cy384/ppk_usb/(list of files, cad)

Other CAD files:
palm-V-adapter.scad
