cy384/ppk_usb/(threads)

Thread 1 (2015-04-12):

Possible Updates?

danielfrausto, 2015-04-12:
hi i have been following your work. Might it be possible for you to help port this code to leonardo?
Also i am using landware gotype keyboard for pam III? can you help?

cy384, 2015-04-12:
I'm fairly confident the code should run on a Leonardo with no changes (or just changing some of the pin numbers, maybe).

As for the landware keyboard, unfortunately, I can't find any technical information about it online (and I don't have one), so it would be harder to figure out.  You would probably need a logical analyzer or something to capture and reverse engineer the communications.

DB35M, 2015-04-13:
Hi i  am also using leonardo. i am having problems with pin 15 from your micro pro... there is no pin 15 on leonardo. I have read Micro pro schematic and pin 15 i s SCK but on leonardo that pin goes to ICP.

cy384, 2015-04-15:
You should be able to change that (the PULLDOWN_PIN macro) to basically any other pin you want to wire up, or just ignore it and pull down using GND.

Closed 2015-05-03.

Thread 2 (2015-10-29):

Any way to debug?

hryamzik, 2015-10-29:
Hi @cy384!

I've connected everything exactly as you've described and it doesn't work. Should the board always appear in the system as "Leonardo" or should there be a different name in a keyboard mode?

cy384, 2015-10-29:
Hi, just added a debug option, try it out by grabbing the latest code and recompiling with DEBUG set to 1.  It should at least give you an idea of where in the process it's failing to work (it will print to the arduino serial monitor).  The board will continue to show up as a leonardo in lsusb or similar lists.

Beyond looking at that, checking your wiring again, make sure you defined PPK_VERSION correctly for your keyboard, maybe poke at it with a multimeter/logic analyzer if you have one, dig into the code and the specification for the keyboard, and hope you don't have any dead hardware.

If you have an extra atmega32u4 based arduino, you could try wiring it up on a solderless breadboard and use test hooks to connect it to the keyboard until you can get it working (which is how I initially did mine before the 3d printed parts).

hryamzik, 2015-10-29:
Got it, thanks!

hryamzik, 2015-10-29:
@cy384 the bad news is that I can see nothing in the serial console. The good news is that it actually started working, should have been a contact issue on a bread board.

Let me ask two more questions:

1. What's the reason for wiring pins 6 and 8 (in a palm V version)?
2. Can I just replace pin 15 with pin 9 (I would like to use an SMD resistor)

cy384, 2015-10-29:
Regarding the issues with the serial console, often I have to make sure manually that it's choosing the right usb/serial port every time I connect the device.

1.  The two reasons for the strange wiring: firstly, simply getting everything to physically fit nicely, and secondly, for reasons unknown to me I could only get the keyboard serial connection to work on certain pins (which I found by just testing them one by one).  I suspect the latter has something to do with interrupts used by the software serial library, but didn't investigate further once I found a way to make it work.

2.  You could replace 15 with any unused I/O pin if you adjust PULLDOWN_PIN, or even just use ground.  It's only used to pull down the serial pin.  15 was just located conveniently for a normal 1/4W through-hole resistor.

Closed 2015-10-29.

Thread 4 (2016-01-05):

Error uploading

alchle, 2016-01-05:
cy384,

Found this great post on github and am trying it out.  I 3D printed the parts (fits nicely) and am ready to upload the code.  I want to test it on an Arduino Uno first before purchasing a Leonardo and maybe that is my problem. I was hoping that I could connect the Arduino Uno to my tablet and see how well it works, it has a USB port and built in serial communication like the Leonardo.

When I upload the code (changed to Palm V) I get the following errors... looks like it doesn't like the config keymap functions.  Board in Arduino IDE is Arduino Uno, and programmer is USBtinyISP (I never change this setting)

Palm_Keyboard.ino: In function 'void config_keymap()':
Palm_Keyboard:87: error: 'KEY_LEFT_GUI' was not declared in this scope
Palm_Keyboard:107: error: 'KEY_CAPS_LOCK' was not declared in this scope
Palm_Keyboard:108: error: 'KEY_TAB' was not declared in this scope
Palm_Keyboard:109: error: 'KEY_LEFT_CTRL' was not declared in this scope
Palm_Keyboard:120: error: 'KEY_LEFT_ALT' was not declared in this scope
Palm_Keyboard:139: error: 'KEY_BACKSPACE' was not declared in this scope
etc...
for all key_map in both functions:  'void config_keymap()' & void config_fnkeymap()'

Please help.

Thanks

cy384, 2016-01-05:
The Arduino Uno isn't able to easily act as a USB keyboard, so it doesn't have the KEY_LEFT_GUI etc. available for this code.  If you want to just see if you can get the serial stuff working, you could try experimenting with this quickly edited version of the code, which will just print the keypresses to the serial console: https://gist.github.com/cy384/dd638ba8a37c22766444

If you want to use this as a USB keyboard, though, you'll need to get a Leonardo, Pro Micro, or other Arduino with an Atmega32U4.

alchle, 2016-01-06:
Worked great.  Thank you.  I ordered a Leonardo.

Great work!

-Allen

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

techsetonyoutube, 2017-03-31:
get a Digispark board there small and cheap!

http://www.ebay.com/itm/like/191544650607?lpid=82&chn=ps&ul_noapp=true

Closed 2016-01-05.

Thread 5 (2016-02-04):

Sometimes works on computer, Not on tablets

alchle, 2016-02-04:
Dear cy384,

I was successful in making the adapter.  I have gotten the palm keyboard to work on my WinXP and Win7 machines, however, it's not always successful... Very first time plugged into my WinXP machine USB port it worked perfectly, but when I unplugged it and plugged in back i, it doesn't work.  Computer makes the sounds of added USB item and says ready to use but the keyboard doesn't work.  Unplug, plug and repeat... no go.  Finally, I plugged it in and grounded the Reset pin with a paper clip and released, now it works (until I unplug and replug again). (Any time is is plugged in the micro controller has the led light on).  I know when it working because the red led with flash with each keypress.

Next issue is I can't get it to work with my tablets.  A normal keyboard will work just fine (no powered USB hub needed) but for some reason the tablets won't see the Leonardo device.  Driver perhaps?  Tried on 3 different tablet models/manufacturers.  Any thoughts here?  This is why I made it in the first place.

Awesome work on your part.  Thank you for posting it and help.

-Allen

cy384, 2016-02-06:
For determining what problems you're having on your PC, I would advise compiling the firmware in debug mode (set PPK_DEBUG to 1 in the .ino file) and looking at what is printed in the serial console.  That should let you see where it's getting stuck, and possibly what to do about it.  I think you could also look at Windows Device Manager and make sure it shows up as a USB keyboard/HID.

I'm not sure why it would work on your PC and not on tablets; it has worked on all computers and (android) mobile devices I've tested on.  I don't think any additional drivers should be necessary.  It may be related to the intermittent problems you've been having with the PCs.  Unfortunately, I don't know what tools would be useful for figuring out what's happening on phones/tablets.

Hope this helps.

Thread 6 (2016-05-30):

Pin 15 non-existent on arduino Leonardo

DavidVentura, 2016-05-30:
Hi
I have an original arduino leonardo which I'll try to use to test this with my v3 PPK.. thing is I have up to Pin 13. Following this:

MISO, MOSI and SCK:
First there is an SPI header on the Leonardo board. The pins connected to the SPI header are MISO (PB3), MOSI (PB2) and SCK (PB1). If you want to use them as I/O pins here is a secret. You can use them same as any other digital pin on Leonardo. Use the corresponding digital pin number:
MISO as digital pin 14
MOSI as digital pin 16
SCK as digital pin 15

I get that  I should use the SCK pin (upper middle) on the  SPI header
 Thanks

DavidVentura, 2016-05-30:
Well, I couldn't wait. Yes, the SCK pin works. I am typing from my new PPK!

cy384, 2016-05-30:
Great to hear you've got it working, enjoy!

For the record, the exact pins used aren't critical, you could probably tweak the code to use most other pins instead.

Closed 2016-05-30.

Thread 7 (2016-05-31):

Making it work on ATMega328

DavidVentura, 2016-05-31:
Do you believe this should work on a 328? I can get them for 6USD where I am and the 32u4 costs 24USD.
It seems able to work as a HID device and has software serial compatibility

cy384, 2016-06-01:
The smaller arduinos/atmega devices can do hacky low-speed USB, but you'd still need a few more parts (zener diodes, etc.), and the code for this project would need to be adapted.  So, probably possible in a technological sense, but it would take more work and experimentation.

Closed 2016-06-01.

Thread 8 (2017-04-17):

can I use the original palm connector

rhubarb, 2017-04-17:
Hi I'm very interested in reviving my PPK from the brick-like hibernation it's been in since I upgraded from a Palm V to a Tungsten oh many moons ago. But I don't have access to a 3D printer.
I _do_ still have my Palm V that the keyboard worked with. Can I pull out it's connector and use it instead?

cy384, 2017-04-20:
Last time I looked (I may be wrong), the connector piece of a Palm V was not a nice independent module that you could pull out, and was pretty integrated into the rest of the hardware.  If you're not worried about making a nicely removable adapter, you could do something like soldering directly to the connector pins on the keyboard.

Closed 2017-07-12.

Thread 9 (2017-07-12):

Unable to upload to Pro Micro

trizex, 2017-07-12:
Hello, I hope you can shed some light on the issue that i'm having. I bought a knockoff from aliexpress

https://www.aliexpress.com/item/New-Pro-Micro-ATmega32U4-5V-16MHz-Replace-ATmega328-for-Ar-Pro-Mini/1859136734.html

It identifies itself in IDE as Arduino Leonardo, but once i try to upload the file, it comes back with a
"KEY_LEFT_GUI" not declared in this scope. Basically the same issue you already had reported by somebody else, so I tried your debugging file (nokeyboard), and....that works. Do you have any ideas as to why I'm experiencing this issue, is the knockoff to blame or? The board looks damn near identical to the one you used. Thank you in advance, hope you can help me out.

trizex, 2017-07-12:
Rhis is the complete error log

Arduino: 1.8.3 (Windows 7), Board: "Arduino Leonardo"

.....ppk_usb-master\ppk_usb-master\arduino_ppk_usb\arduino_ppk_usb.ino: In function 'void config_keymap()':

arduino_ppk_usb:88: error: 'KEY_LEFT_GUI' was not declared in this scope

   key_map[0b00001000] = KEY_LEFT_GUI; // "CMMD" or "Cmd"

                         ^

arduino_ppk_usb:108: error: 'KEY_CAPS_LOCK' was not declared in this scope

   key_map[0b00011000] = KEY_CAPS_LOCK;

                         ^

arduino_ppk_usb:109: error: 'KEY_TAB' was not declared in this scope

   key_map[0b00011001] = KEY_TAB;

                         ^

arduino_ppk_usb:110: error: 'KEY_LEFT_CTRL' was not declared in this scope

   key_map[0b00011010] = KEY_LEFT_CTRL;

                         ^

arduino_ppk_usb:121: error: 'KEY_LEFT_ALT' was not declared in this scope

   key_map[0b00100011] = KEY_LEFT_ALT;

                         ^

arduino_ppk_usb:140: error: 'KEY_BACKSPACE' was not declared in this scope

   key_map[0b00110010] = KEY_BACKSPACE;

                         ^

arduino_ppk_usb:159: error: 'KEY_RETURN' was not declared in this scope

   key_map[0b01000001] = KEY_RETURN;

                         ^

arduino_ppk_usb:169: error: 'KEY_UP_ARROW' was not declared in this scope

   key_map[0b01001001] = KEY_UP_ARROW;

                         ^

arduino_ppk_usb:178: error: 'KEY_DELETE' was not declared in this scope

   key_map[0b01010000] = KEY_DELETE;

                         ^

arduino_ppk_usb:179: error: 'KEY_LEFT_ARROW' was not declared in this scope

   key_map[0b01010001] = KEY_LEFT_ARROW;

                         ^

arduino_ppk_usb:180: error: 'KEY_DOWN_ARROW' was not declared in this scope

   key_map[0b01010010] = KEY_DOWN_ARROW;

                         ^

arduino_ppk_usb:181: error: 'KEY_RIGHT_ARROW' was not declared in this scope

   key_map[0b01010011] = KEY_RIGHT_ARROW;

                         ^

arduino_ppk_usb:188: error: 'KEY_LEFT_SHIFT' was not declared in this scope

   key_map[0b01011000] = KEY_LEFT_SHIFT;

                         ^

arduino_ppk_usb:189: error: 'KEY_RIGHT_SHIFT' was not declared in this scope

   key_map[0b01011001] = KEY_RIGHT_SHIFT;

                         ^

......\ppk_usb-master\ppk_usb-master\arduino_ppk_usb\arduino_ppk_usb.ino: In function 'void config_fnkeymap()':

arduino_ppk_usb:200: error: 'KEY_HOME' was not declared in this scope

   fn_key_map[0b01010001] = KEY_HOME; // left arrow

                            ^

arduino_ppk_usb:201: error: 'KEY_PAGE_DOWN' was not declared in this scope

   fn_key_map[0b01010010] = KEY_PAGE_DOWN; // down arrow

                            ^

arduino_ppk_usb:202: error: 'KEY_END' was not declared in this scope

   fn_key_map[0b01010011] = KEY_END; // right arrow

                            ^

arduino_ppk_usb:203: error: 'KEY_PAGE_UP' was not declared in this scope

   fn_key_map[0b01001001] = KEY_PAGE_UP; // up arrow

                            ^

arduino_ppk_usb:204: error: 'KEY_ESC' was not declared in this scope

   fn_key_map[0b00011001] = KEY_ESC; // tab key

                            ^

arduino_ppk_usb:205: error: 'KEY_F1' was not declared in this scope

   fn_key_map[0b00000000] = KEY_F1; // 1

                            ^

arduino_ppk_usb:206: error: 'KEY_F2' was not declared in this scope

   fn_key_map[0b00000001] = KEY_F2; // 2

                            ^

arduino_ppk_usb:207: error: 'KEY_F3' was not declared in this scope

   fn_key_map[0b00000010] = KEY_F3; // 3

                            ^

arduino_ppk_usb:208: error: 'KEY_F4' was not declared in this scope

   fn_key_map[0b00000100] = KEY_F4; // 4

                            ^

arduino_ppk_usb:209: error: 'KEY_F5' was not declared in this scope

   fn_key_map[0b00000101] = KEY_F5; // 5

                            ^

arduino_ppk_usb:210: error: 'KEY_F6' was not declared in this scope

   fn_key_map[0b00000110] = KEY_F6; // 6

                            ^

arduino_ppk_usb:211: error: 'KEY_F7' was not declared in this scope

   fn_key_map[0b00000111] = KEY_F7; // 7

                            ^

arduino_ppk_usb:212: error: 'KEY_F8' was not declared in this scope

   fn_key_map[0b00110100] = KEY_F8; // 8

                            ^

arduino_ppk_usb:213: error: 'KEY_F9' was not declared in this scope

   fn_key_map[0b00110101] = KEY_F9; // 9

                            ^

arduino_ppk_usb:214: error: 'KEY_F10' was not declared in this scope

   fn_key_map[0b00110110] = KEY_F10; // 0

                            ^

arduino_ppk_usb:215: error: 'KEY_F11' was not declared in this scope

   fn_key_map[0b00110000] = KEY_F11; // -

                            ^

arduino_ppk_usb:216: error: 'KEY_F12' was not declared in this scope

   fn_key_map[0b00110001] = KEY_F12; // =

                            ^

.....\ppk_usb-master\ppk_usb-master\arduino_ppk_usb\arduino_ppk_usb.ino: In function 'void setup()':

arduino_ppk_usb:348: error: 'Keyboard' not found. Does your sketch include the line '#include <Keyboard.h>'?
   Keyboard.begin();

   ^

......\ppk_usb-master\ppk_usb-master\arduino_ppk_usb\arduino_ppk_usb.ino: In function 'void loop()':

arduino_ppk_usb:379: error: 'Keyboard' not found. Does your sketch include the line '#include <Keyboard.h>'?
         Keyboard.releaseAll();

         ^

arduino_ppk_usb:389: error: 'Keyboard' not found. Does your sketch include the line '#include <Keyboard.h>'?
             Keyboard.release(key_code);

             ^

arduino_ppk_usb:393: error: 'Keyboard' not found. Does your sketch include the line '#include <Keyboard.h>'?
             Keyboard.press(key_code);

             ^

exit status 1
'KEY_LEFT_GUI' was not declared in this scope

trizex, 2017-07-12:
So for future reference, I managed to get it working. It was missing a line ,the IDE told me but I wasn't listening :D

"#include <Keyboard.h>"

And voilla, it wooooorks :D

cy384, 2017-07-12:
glad you got it working!

Closed 2017-07-12.

Thread 10 (2017-10-13):

using a usb to serial converter?

bijlevel, 2017-10-13:
This is a shot in the dark, but just using a usb to serial converter, like http://www.sigma-shop.com/product/79/modulo-usb-seriale-ft232rl-usb-b-ub232r-atmel-avr-microchip-pic-arduino.html, would that work? Or is it indeed necessary to use a programmable board to get the right key codes? TIA!

cy384, 2017-10-13:
It's probably possible to get data from the keyboard using an RS232 adapter, but you'd also have to do something to turn that into keyboard input on the computer, and it wouldn't be any cheaper or simpler, so I think the arduino-based solution as done in this project is the most reasonable option.

bijlevel, 2017-10-14:
Thanks for the reply! I will try to implement your solution.

Regards,
Sjoerd W. Bijleveld

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

Closed 2017-10-13.

Thread 11 (2018-03-14):

Not sure how to use SCAD files

fionnafire, 2018-03-14:
I know this is pretty old, but can you please provide a more universal file such as an STL please?

fionnafire, 2018-03-14:
oof. I have hardly used Github

cy384, 2018-03-15:
thanks for your interest, the files can be opened with [OpenSCAD](http://www.openscad.org/), and it's pretty easy to generate an STL.  As I'm traveling right now, it might be a few days, but I'll upload some as soon as I can.

fionnafire, 2018-03-15:
thank you very much! I can't wait to get this thing working on my phone.

cy384, 2018-05-02:
Sorry for the delayed response, coursework has kept me very busy for the past two months (finals ended yesterday).  [I've added a 1.0.0 release and attached the compiled STLs.](https://github.com/cy384/ppk_usb/releases/tag/v1.0.0)

If you need to tweak the files, you can also try pasting the code into [this in-broswer openscad.](http://openscad.net/)

fionnafire, 2018-05-03:
Thank you so much. You of course had no obligation to make the STL files for me, I really appreciate your work!

I hope your finals went well, and honestly my own college and work schedule would have kept me from being able to make this thing myself anyway. So no worries about the delay.

Closed 2018-03-15.

Thread 12 (2018-05-29):

Is it real to connect palm keyboard to PC rs232 (on ms dos)?

be3max, 2018-05-29:
Is it real to connect palm keyboard to PC rs232 (on ms dos)? I`m own old [HP 200lx](https://en.wikipedia.org/wiki/HP_200LX) that's have a rs232 port, these handledPC work on ms dos, and i searching info about keyboard connection on rs232.
HP 200lx can connect with [Apple Newton keyboard](http://www.palmtoppaper.com/ptphtml/36/pt360021.htm) + driver, but which hard to find nowadays :(

cy384, 2018-06-24:
That looks like a cool device!

Can it conceivably be done? I suspect yes.  Do I have any idea how to do it? Nope!  It would probably also need a special driver, in addition to figuring out the wiring.

Sorry I can't help, I hope you figure something out and can keep the old hardware alive.

Closed 2018-06-24.

Thread 13 (2019-04-26):

Bluetooth connectivity

hmngsghst, 2019-04-26:
Hello! Thanks for sharing this cool mod! Have started to fiddle with electronics, found a PPK at the flea market, googled for an adapter and was happy to find your mod. Am thinking about doing it and was wondering about the possibility of BT connectivity with new BLE-equipped 32u4 boards like the Adafruit Feather 32u4 Bluefruit LE. It seems possible, but without any experience with Arduinos and not much knowledge in electronics and programming, would it be too much of a hassle/hard and too much for a beginner to get this working via bluetooth? Would it need for example power on/off buttons and such? Will be doing it anyway with or without the bluetooth and am ready to put some work into it as a learning experience.

cy384, 2019-04-27:
I'm sure it's possible, though I can't say how hard it would be for a beginner.  I think a person could get it working pretty easily based on the tutorials for the feather/bluefruit boards.  The 3D printed parts won't be sized correctly for the board with a battery, and exact pin numbers used will be different, but those should be relatively straight-forward to figure out.  You could probably just have a slide switch on the battery connection for the power.

hmngsghst, 2019-04-30:
Reading up on the stuff it doesn't seem too hard... Still looking at different possibilities. Might get a bit bulky with the battery, and the cost too..Thanks for the help!

Thread 14 (2019-05-19):

keyboard.h

CableGuy67, 2019-05-19:
I finally sat down to finish this project and it went about as smooth as could be. So thanks for all your work!

The only issue I had with Arduino 1.8.5 and building for a Pro Micro (ish, from ebay) I had to add:
`#include <Keyboard.h>`
just after the SoftwareSerial include to get it to compile. After that, I was able to upload  the sketch and type this out on my old Palm keyboard.
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

cy384, 2019-05-19:
it's very encouraging to see a successful build, thanks for sharing!  I've added the header in the last commit.

Closed 2019-05-19.

Thread 15 (2020-08-31):

for Handspring

aoshimak, 2020-08-31:
I tried for Palm3 and Palm5 keyboards as like below. They works well.
https://github.com/milestogo/qmk_firmware/tree/master/keyboards/converter/palm_usb

But I also try to make Handspring one, it is not works well, no keyboard signals goes to PC.
I use ProMicro with self compiled firmware, wired like this from this information:
Handspring: [VCC/TXD, NC, NC, NC, GND, NC, NC, RXD]

ProMicro      Handspring
2             1(VCC/TXD)
3             8(RXD)
GND           5(GND)
On ProMicro, 10kohm register connects between 3 to GND for pull-up.

If you have any ideas about Handspring devices, thanks in any advice.

cy384, 2020-09-01:
I think the only important difference with the Handspring devices is that the handshake bytes it sends will be "F9 FB" instead of "FA FD", so you could try changing that in the code, looks like the function "palm_handshake" on the link you gave.

hope that helps!

aoshimak, 2020-09-02:
Thank you for your reply.
On qmk palm_usb converter, that is based on your code.
And Handspring option seems on config.h

Then, who is the transporter from your code to qmk?

cy384, 2020-09-02:
I don't know, sorry.

aoshimak, 2020-09-08:
Thanks.

FedX-sudo, 2021-10-03:
I just got myself a stowaway keyboard thinking this would, work. Turns out its the Handspring version, and I was wondering if there was any progress getting the Hanspring working. Thanks!

clach04, 2025-02-20:
> Thank you for your reply. On qmk palm_usb converter, that is based on your code. And Handspring option seems on config.h
>
> Then, who is the transporter from your code to qmk? Please tell me if you know.

I **think** https://github.com/milestogo/qmk_firmware/tree/palm_usb

Thread 16 (2020-09-13):

Keyboard stuck most of the time on "waiting for keyboard serial ID..."

VectorKappa, 2020-09-13:
Hello. I've been using a german version of palm keyboard (V version) for a while now, and some time ago the keyboard stopped getting recognized on my android phone. Sometimes replugging the adapter worked, but lately it doesn't work at all.

I tried placing something in the while loop, to prevent my phone from going to low-power otg mode, but to no avail.
Very rarely, recompiling fixes the issue, but only for one launch.

As far as I can see, everything seems to be soldered on correctly, but could it be the cat.5 wire fault? It looks flimsy. I could switch it to some silver-plated copper wire, but I don't want to potentially waste it.

cy384, 2020-09-13:
I think the most likely issue is the contact between the wire on the adapter and the connector on the keyboard.  You can try to poke them around to see if that improves the connection.

I've been considering redesigning the 3D printed part to hold the wires better, the current design isn't perfect.

VectorKappa, 2020-09-14:
Alright, that was entirely my fault for using a cheap cat5 found in my toolbox. I scraped the patina off the wires with a small file, works like a charm. I'll probably replace the wires.

Thanks for the response!

Closed 2020-09-14.

Thread 17 (2020-12-31):

HP Pocket PC version?

joeskeen, 2020-12-31:
I used to have one of these keyboards for my old palm pilot, but somehow it got lost. I just picked up one of these stowaway keyboards, but it was built for Pocket PC, Windows key and all. I'm planning to convert mine into a general purpose usb-c keyboard, but I found an image on the web that makes me wonder if I could do the conversion without an Arduino:

https://newatlas.com/thanko-full-size-usb-folding-keyboard/14897/

This is definitely the same keyboard, but if you take a look at the pictures, one shows a usb cable attached. I'm wondering if I remove that panel, perhaps there is a ready-for-usb circuit I can attach to? If so, this could greatly simplify the conversion process for all stowaway keyboards.

Wish me luck!

joeskeen, 2020-12-31:
Ok, so I got it apart, and didn't find some magical USB connection spot on the PCB (hey, I can dream, can't I?)

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

My guess is that the picture I found featured a different PCB under the hood.

joeskeen, 2020-12-31:
After doing a little more research, I think I'll use this project with an Arduino Seeeduino XIAO - the size of a quarter and costs under $5. The plan is I can replace all the wiring on the left for the pocket PC with the board and 3D print an enclosure for it.

https://www.seeedstudio.com/Seeeduino-XIAO-Arduino-Microcontroller-SAMD21-Cortex-M0+-p-4426.html

cy384, 2020-12-31:
some changes will need to be made to the code, but it seems like all of the details for pocketpc are available in the reference document I link in the readme, and it's nothing particularly hard.

a problem you may have with that board is that it only supports 3.3V, not 5V, and the keyboard electronics probably need to run and interface at 5V.

joeskeen, 2020-12-31:
That's some good information, thanks!

cy384, 2021-01-06:
now that I look at the PCB again, I think it has a voltage regulator on it, it may run fine at 3.3V if you bypass that, when I have a chance I'll look at the voltages on mine

Thread 18 (2023-07-14):

Have to Constantly Reflash

esp328, 2023-07-14:
Hello,
I recently built the usb adapter for the ppk but my one issue is that the only way to get it to register keypresses is by reflashing the Arduino every time I want to use it. Would you know why that might be? I tried debugging with arduino ide but I saw nothing.

Closed 2023-07-23.
