cy384/ppk_usb/(commit log)

2015-02-18 basic 3d printable socket for PPKs with the palm III style header
    [palm-III-adapter.scad]
2015-02-20 basic 3d printable socket for PPKs with the palm V style header
    [palm-V-adapter.scad]
2015-02-22 updating readme with 3D printing information
2015-03-05 adjusting variable names in adapter files
    [palm-III-adapter.scad, palm-V-adapter.scad]
2015-03-05 removing dead code
    [palm-V-adapter.scad]
2015-03-05 fixing typo in comment in palm v scad file
    [palm-V-adapter.scad]
2015-03-05 Adding openscad design for pro micro mount
    [pro-micro-socket.scad]
2015-03-06 tightening base size a little
    [pro-micro-socket.scad]
2015-03-07 adding extra room on the bottom of the pro micro socket
    [pro-micro-socket.scad]
2015-04-01 fixing pins for palm V adapter
    [arduino_ppk_usb.ino]
2015-04-03 fixing z placement of pro micro socket bottom
    [pro-micro-socket.scad]
2015-04-03 adding pin configuration macro to the arduino code
2015-04-03 adding assembly instructions and pics to readme
2015-04-03 adding friction welding link to readme
2015-06-02 removing bit of dead code from palm iii adapter scad
    [palm-III-adapter.scad]
2015-10-29 adding a debug mode that displays information to arduino Serial
2015-10-30 Moved ESC key to fn+tab
2015-11-04 Implemented byte code print for undefined keys in debug mode
2015-11-04 style edit to code for printing undefined keypresses
2015-11-04 cleaning up debug printing of key presses/releases
2015-11-11 adding license headers to other files
    [palm-III-adapter.scad, palm-V-adapter.scad, pro-micro-socket.scad]
2019-05-19 fix missing include (see issue #9 and issue #14)
    [arduino_ppk_usb.ino]
2019-08-29 fix missing debug check
    [arduino_ppk_usb.ino]
